NikkiRe/Robot-micromouse/README.md

# Micromouse: робот, проходящий лабиринт

> Базовый прототип сделан командой на курсе «Системы ввода-вывода» ИТМО, весна 2026 (https://github.com/krevetkot/robot).
> Навигация (симулятор, flood-fill, прошивка v2) развивается здесь — см. раздел в конце, `sim/README.md` и `firmware-v2/README.md`.

Автономный робот для соревнований Micromouse (регламент РобоФинист). Робот сам находит
путь от старта к финишу по коридорам лабиринта, без какого либо участия человека.
Прошивка написана под STM32 на голом HAL, движение строится по показаниям трёх
ИК-датчиков (реактивное управление, без построения карты).

Проект сделан в рамках дисциплины «Системы ввода-вывода».

## Что внутри

- `Core/Src/main.c` вся логика робота: управление моторами, чтение датчиков, алгоритм движения
- `Core/Inc/` заголовки и конфигурация HAL
- `Drivers/` библиотека STM32 HAL (генерируется CubeMX)
- `robot.ioc` проект STM32CubeMX (распиновка и настройка периферии)
- `STM32F401CCUX_FLASH.ld` скрипт линковки
- `Debug/` каталог сборки
- `docs/` презентация проекта

## Железо

| Компонент | Модель | Кол-во |
|---|---|---|
| Микроконтроллер | STM32 Black Pill (F401CCU6) | 1 |
| Драйвер моторов | TB6612FNG (2 канала, до 3 А) | 1 |
| Моторы | N20 micro gear, 3-6 В | 2 |
| Колёса | 30 мм | 2 |
| ИК-датчики | регулируемые, YL-63 | 3 |
| Преобразователь питания | Mini360 (DC-DC, понижающий) | 1 |
| Аккумулятор | Крона 9 В Li-Ion, 1200 мА·ч | 1 |
| Корпус | FDM-печать, PLA-пластик | 1 |

Питание: аккумулятор 9 В идёт на понижающий преобразователь Mini360, с него 3.3 В
на логику и моторы. При тестировании вся электроника заработала от 3.3 В, поэтому
оставили один преобразователь.

## Распиновка

Драйвер моторов TB6612FNG:

| Сигнал | Пин | Назначение |
|---|---|---|
| AIN1 | PA5 | правый мотор, направление 1 |
| AIN2 | PA6 | правый мотор, направление 2 |
| BIN1 | PA2 | левый мотор, направление 1 |
| BIN2 | PA3 | левый мотор, направление 2 |
| STBY | PA9 | разрешение работы драйвера (HIGH) |
| PWMA | PA8 | вход ШИМ канала A, подтянут в HIGH |

ИК-датчики (активный LOW: 0 означает препятствие):

| Датчик | Пин |
|---|---|
| правый | PB0 |
| левый | PB1 |
| центральный | PA4 |

Индикация:

| Сигнал | Пин | Назначение |
|---|---|---|
| светодиод | PC13 | загорается при обнаружении препятствия и манёвре |

## Как работает алгоритм

Робот не строит карту лабиринта. Он принимает решения по текущим показаниям
датчиков (реактивное управление). Основной цикл в `main.c`:

1. Если **спереди свободно**, едет вперёд короткими импульсами.
2. Если **спереди препятствие**, останавливается, зажигает светодиод и делает паузу,
   затем читает боковые датчики и выбирает манёвр:
   - слева свободно, справа занято -> поворот влево
   - справа свободно, слева занято -> поворот вправо
   - оба бока свободны -> поворот вправо по умолчанию
   - заблокировано со всех сторон -> сдаёт назад и разворачивается примерно на 180°
3. После поворота немного проезжает вперёд, чтобы не зациклиться у той же стены.

Скорость задаётся программным ШИМ (soft-PWM) без аппаратного таймера: робот
по очереди едет 40 мс и стоит 20 мс, что даёт примерно 67% мощности. Чтобы ехать
медленнее, уменьшите время движения или увеличьте время паузы.

Ключевые параметры (в начале `main()`):

```c
#define SPEED_ON_MS   40   // длительность импульса движения
#define SPEED_OFF_MS  20   // пауза между импульсами
#define PRE_TURN_MS   120  // пауза перед поворотом
#define POST_TURN_MS  100  // пауза после поворота
```

Длительности поворотов заданы в миллисекундах прямо в коде: примерно 450 мс на
поворот на 90° и около 840 мс на разворот. При смене колёс, мотора или заряда
батареи эти значения, скорее всего, придётся подстроить.

## Сборка и прошивка

Прошивка собирается в STM32CubeIDE.

1. Откройте папку проекта в STM32CubeIDE (`File -> Open Projects from File System`).
2. Соберите проект (`Project -> Build Project`). Готовый бинарник появится в `Debug/`.

Прошивается плата не через ST-Link, а через USB Type-C во встроенном DFU-загрузчике.
Чтобы войти в режим прошивки, нужно полностью перезагрузить STM32 в DFU:

1. Подключите плату к компьютеру кабелем USB Type-C.
2. Зажмите кнопку BOOT0, нажмите и отпустите кнопку RESET (NRST), затем отпустите
   BOOT0. После этого полного ребута плата запустится в DFU-загрузчике.
3. Прошейте бинарник через STM32CubeProgrammer (интерфейс USB) или `dfu-util`,
   например `dfu-util -a 0 -s 0x08000000:leave -D Debug/robot.bin`.
4. По завершении плата сама перезапустится в обычном режиме и начнёт работать.

Можно также открыть `robot.ioc` в STM32CubeMX, если нужно поменять распиновку или
настройки периферии, а затем перегенерировать код.

## Как запустить робота

1. Зарядите аккумулятор 9 В и вставьте его в держатель на роботе.
2. Подключите штекер питания. Робот стартует сразу, отдельной кнопки включения нет.
3. За время после включения поставьте робота в стартовую ячейку, направив датчиками
   вдоль коридора.
4. Следите за светодиодом PC13: он загорается, когда робот видит препятствие и
   начинает манёвр.

Управление полностью автономное: после включения вмешательство не требуется и не
предусмотрено. Перед заездом проверьте заряд батареи и при необходимости подстройте
пороги срабатывания ИК-датчиков под освещение в помещении (регулировочными
резисторами на самих датчиках).

## Соответствие регламенту

| Требование РобоФинист | Наш робот |
|---|---|
| Габариты менее 168 x 168 мм | в пределах лимита |
| Высота и масса | без ограничений |
| Полная автономность | STM32 + датчики, без внешнего управления |
| Не прыгать, не летать, не перелезать стены | обычный колёсный привод |

## Рекомендуемые компоненты для следующей итерации

| Компонент | Текущий | Рекомендация | Причина |
|---|---|---|---|
| Датчики расстояния | YL-63 (цифровой ИК) | **ST VL53L0X** (ToF, I²C) | Аналоговое расстояние в мм вместо бинарного сигнала, нечувствителен к внешнему освещению, рабочий диапазон 30–2000 мм покрывает все дистанции в лабиринте, питание 3.3 В |
| Моторы | N20 3–6 В (низкий RPM) | **N20 3V 265 RPM** с энкодером | 265 RPM на выходном валу даёт ~0.4 м/с при колесе 30 мм. Таким образом, увеличим скорость прохождения, оставив подходящий момент |

**Примечания по интеграции:**
- VL53L0X подключается по I²C (SDA/SCL), библиотека ST HAL доступна на GitHub. Три датчика можно повесить на одну шину, управляя пином XSHUT для назначения разных адресов.
- Повышать напряжение питания не требуется: и VL53L0X, и N20 3V работают от существующих 3.3 В.

## Известные ограничения и планы

- ИК-датчики ложно срабатывают на ярком свету. В планах подобрать другой тип
  датчиков или аналоговые датчики под ПИД-регулятор.
- Направление первого движения зависит от того, насколько ровно выставлен робот.
  Решается ПИД-регулятором для удержания курса.
- Нет кнопки включения, робот стартует сразу при подаче питания.
- Крепление моторов снизу позволит увеличить клиренс и добавить опорный подшипник.
- Моторы с большим RPM дадут больше скорости.

## Команда

- **Ксения Слонимская** схема подключения, сборка
- **Армен Арабян** закупка, 3D-моделирование, сборка
- **Кирилл Слепцов** схема подключения, программирование
- **Никита Евстигнеев** программирование, тестирование

## Состояние базового прототипа

Робот собран и запущен. Реактивное управление проверено на тестовой трассе из коробок:
робот отталкивается от стен и проходит коридор с поворотами (`docs/media/baseline-run.mp4`).
Лабиринт как задачу поиска пути базовая прошивка не решает: у неё нет карты и памяти о
пройденных клетках, поэтому на трассах с циклами она зацикливается. Это отправная точка
для навигационной части.

## Навигация: симулятор и flood-fill

Базовая прошивка не строит карту и на лабиринтах с циклами зацикливается. Чтобы подобрать алгоритм под это железо (три бинарных датчика, моторы без энкодеров), в `sim/` сделан клеточный симулятор и на 500 случайных лабиринтах 16×16 сравнены три стратегии: `reactive` (логика базовой прошивки), `right_hand` (правило правой руки) и `flood_fill` (карта стен + BFS до цели). Подробности и анимации — в `sim/README.md`.

| стратегия | решено | шагов до цели (медиана) | заезд / оптимум |
|---|---:|---:|---:|
| reactive (база) | 25.6 % | 39 | — |
| right_hand | 57.4 % | 98 | — |
| flood_fill | 100 % | 40 | 1.000 |

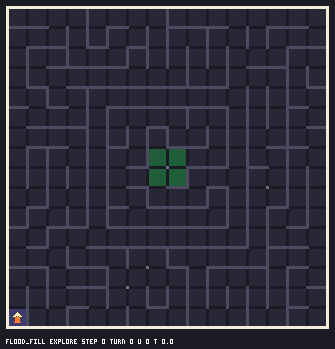
[picture p1: sim/results/viz/island16_flood_fill.gif]
flood-fill на лабиринте с островом


```bash
python -m unittest discover -s tests -t .           # 41 тест
python -m sim bench --n 500 --size 16 --seed 1      # таблица выше
python -m sim viz --maze sim/mazes/island16.txt --strategy flood_fill --out out.gif
```

Прошивка v2 (`firmware-v2/`) — тот же flood-fill на STM32F401 и той же распиновке: модули `maze / nav / motors / sensors / calib`, аппаратный ШИМ через TIM1 вместо программного, медиана по датчикам, калибровка таймингов по кнопке. Модуль карты собирается и на хосте: `cd firmware-v2/host-test && make test` (955 проверок). Ограничения те же, что у базы: движение по времени без энкодеров, бинарные датчики. Подробнее — `firmware-v2/README.md`.

Попутно нашлось расхождение в базовом проекте: в `robot.ioc` пин PA9 настроен как `TIM1_CH2`, а в коде используется как STBY драйвера; в v2 исправлено (`firmware-v2/PINOUT.md`).
