NikkiRe/Robot-micromouse/docs/Micromouse_презентация_5.pdf

// AUTONOMOUS MAZE ROBOT | · 2026

# MICROMOUSE

# Робот, проходящий лабиринт

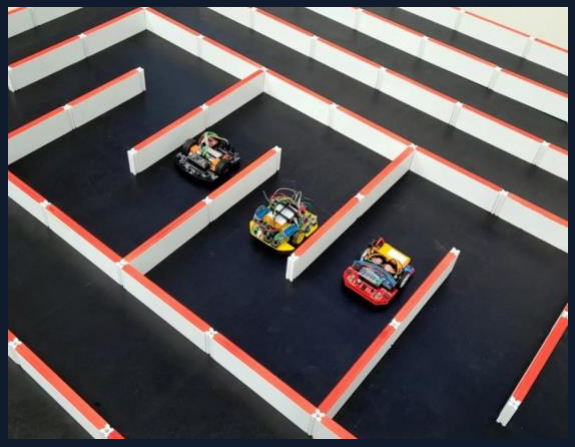
[picture p7: figure]

Проект по дисциплине | | | Цель робота — самостоятельно найти
«Системы ввода-вывода» | | | путь от старта к финишу без участия человека.
STM32F401CCU6 · | TB6612FNG · | 3× IR

СОРЕВНОВАТЕЛЬНЫЙ ЛАБИРИНТ

# Участники проекта

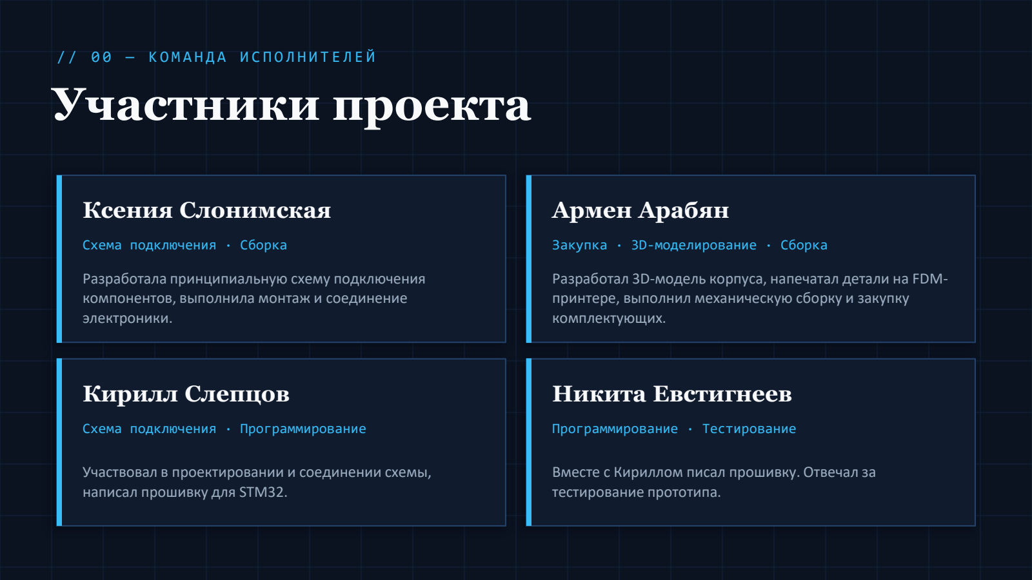
[picture p8: page 2]

/ / 0 0 — К О М А Н Д А И С П О Л Н И Т Е Л Е Й

Ксения Слонимская Схема подключения · Сборка | Армен Арабян Закупка · 3D-моделирование · | Сборка
Разработала принципиальную схему подключения компонентов, выполнила монтаж и соединение | Разработал 3D-модель корпуса, напечатал детали на FDM-принтере, выполнил механическую сборку и закупку
электроники. | комплектующих.
Кирилл Слепцов | Никита Евстигнеев
Схема подключения · Программирование | Программирование · Тестирование
Участвовал в проектировании и соединении схемы, написал прошивку для STM32. | Вместе с Кириллом писал прошивку. Отвечал за тестирование прототипа.

/ / 0 1 — О Б З О Р П Р О Е К Т А

# О проекте

| | | | STM32F401CCU6

### 01 Micromouse — соревновательная дисциплина

робототехники: автономный робот сам находит путь в лабиринте, без вмешательства человека.

### 02 Прототип на STM32 Black Pill (F401CCU6). Три ИК-датчика

читают стены по бокам и спереди, два мотора N20 с колёсами 60 мм приводят робота в движение.

03

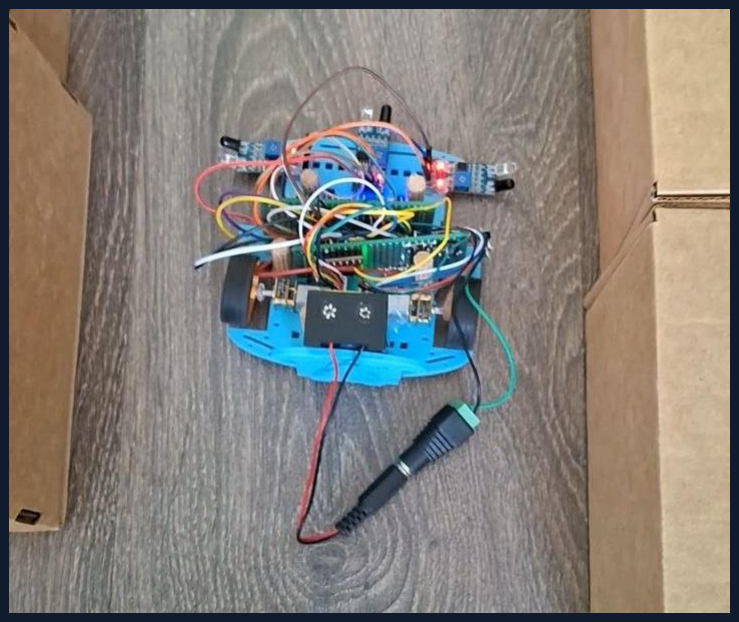
[picture p9: figure]

Питание — аккумулятор 9 В (Li-Ion, 1200 мА·ч) через понижающий преобразователь Mini360 на логику и моторы. | прототип | · реактивное | управление

/ / 0 2 — Ц Е Л Ь И З А Д А Ч И

# Цель и задачи

| Цель: победить в соревновании засчёт разработки автономного робота, способного ориентироваться в
| пространстве и двигаться по коридорам лабиринта, избегая столкновений.
1 | | Проектирование корпуса | 3D-модель компактного шасси под все компоненты
2 | | Электрическая схема | Схема подключения датчиков, моторов, драйвера и
| | контроллера
3 | Сборка прототипа | Печать корпуса, механическая и электрическая сборка
4 | Прошивка: реактивное управление | Алгоритм движения по показаниям датчиков
5 | Тестирование | Проверка на тестовых трассах, устранение ошибок

/ / 0 3 — Р Е Г Л А М Е Н Т · Р О Б О Ф И Н И С Т

# Соответствие требованиям

ТРЕБОВАНИЕ | РЕГЛАМЕНТА | | НАШ РОБОТ
Габариты (Ш×Д) | | < 250 × 250 мм | | в пределах лимита
Высота / масса | | без ограничений | | ограничений нет
Автономность | полная, без внешнего управления | STM32 + датчики
Поведение | не прыгать, не летать, не перелезать | колёсный привод

Команда из 4 человек · лабиринт от 2 до 16 ячеек · неограниченное число заездов, в зачёт идёт лучший

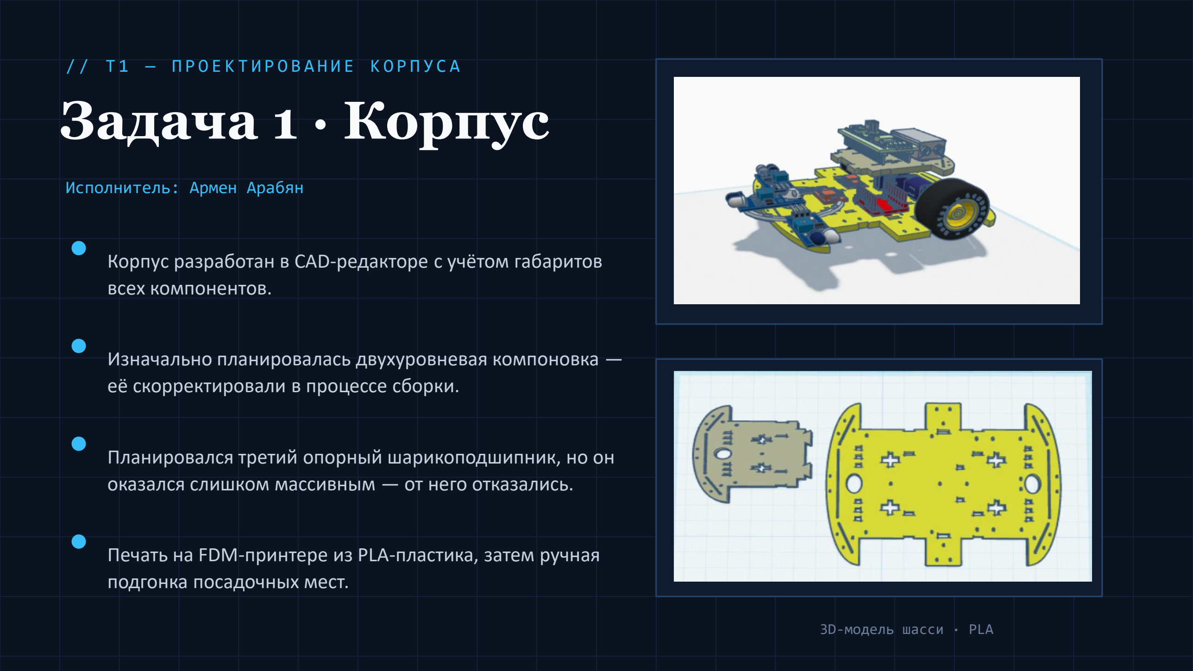
[picture p10: figure]
Задача 1 · Корпус; Исполнитель:; Армен; Арабян; Изначально планировалась двухуровневая компоновка — её скорректировали в процессе сборки.; 3D-модель; шасси · PLA

/ / T 1 — П Р О Е К Т И Р О В А Н И Е К О Р П У С А

Корпус разработан в CAD-редакторе с учётом габаритов всех компонентов.

Планировался третий опорный шарикоподшипник, но он оказался слишком массивным — от него отказались.

Печать на FDM-принтере из PLA-пластика, затем ручная подгонка посадочных мест.

/ / T 2 — С Х Е М А П О Д К Л Ю Ч Е Н И Я

# Задача 2 · Схема

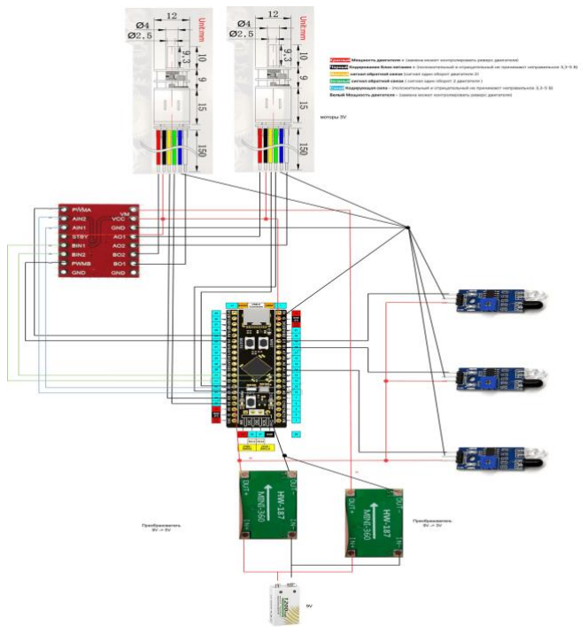
[picture p11: figure]

Исполнители: | Ксения | Слонимская · | | Кирилл Слепцов
Контроллер Драйвер моторов | | | STM32 Black Pill TB6612FNG | | — 2 канала, до 3 А | (F401CCU6)
Правый мотор | | | AIN1=PA5 · AIN2=PA6
Левый мотор | | | BIN1=PA2 · BIN2=PA3
ИК-датчики | | | право=PB0 | | · лево=PB1 · центр=PA4
Управление драйвером | | | STBY=PA9 · PWMA=PA8 (HIGH)
Питание | | | 9 В → Mini360 → 3,3 В

Решение по питанию: при тестировании вся логика заработала от 3,3 В, поэтому оставили один преобразователь.

/ / T 3 · 4 — С Б О Р К А И П Р О Ш И В К А

# Задачи 3–4 · Сборка и код

СБОРКА | ПРОШИВКА
| Реактивное управление Решения по текущим показаниям датчиков, без построения карты
| Движение вперёд
| Soft-PWM: 40 мс едем / 20 мс стоим → ~67% мощности
| Объезд препятствия
Монтаж моторов и колёс в нижней платформе Укладка проводки и пайка соединений | Стоп → читаем боковые → поворот в свободную сторону
Установка ИК-датчиков на передней части | Разворот на 180°
Крепление аккумулятора, преобразователя и штекера | Если заблокированы все стороны: назад + поворот ~840 мс

# Задача 5 · Тестирование

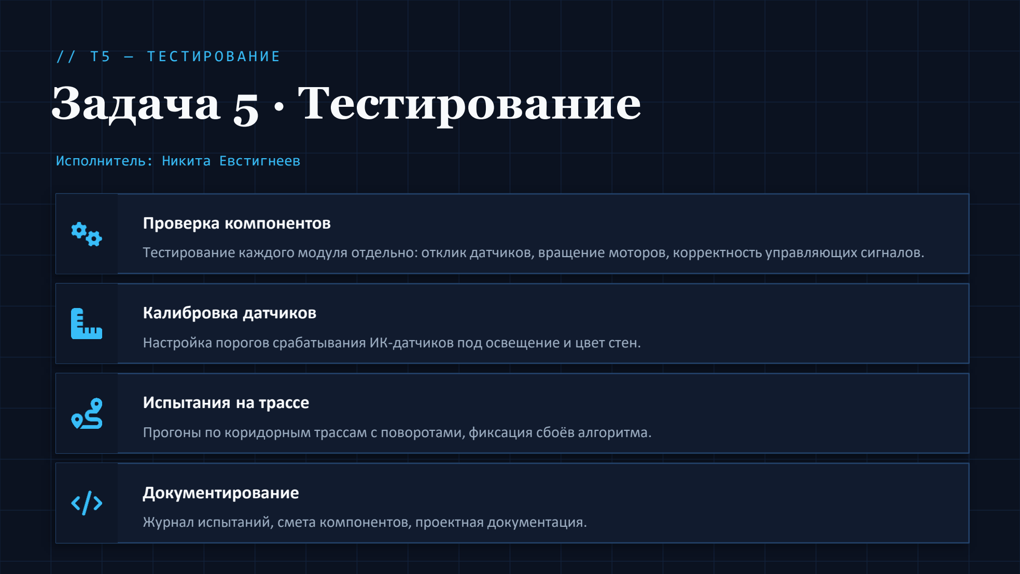
[picture p12: page 9]

/ / T 5 — Т Е С Т И Р О В А Н И Е

Исполнитель: | | Никита Евстигнеев
| Проверка компонентов Тестирование каждого модуля отдельно: отклик датчиков, вращение моторов, корректность управляющих сигналов.

Калибровка датчиков Настройка порогов срабатывания ИК-датчиков под освещение и цвет стен.

### Испытания на трассе

Прогоны по коридорным трассам с поворотами, фиксация сбоёв алгоритма.

### Документирование

Журнал испытаний, смета компонентов, проектная документация.

# Как запустить робота

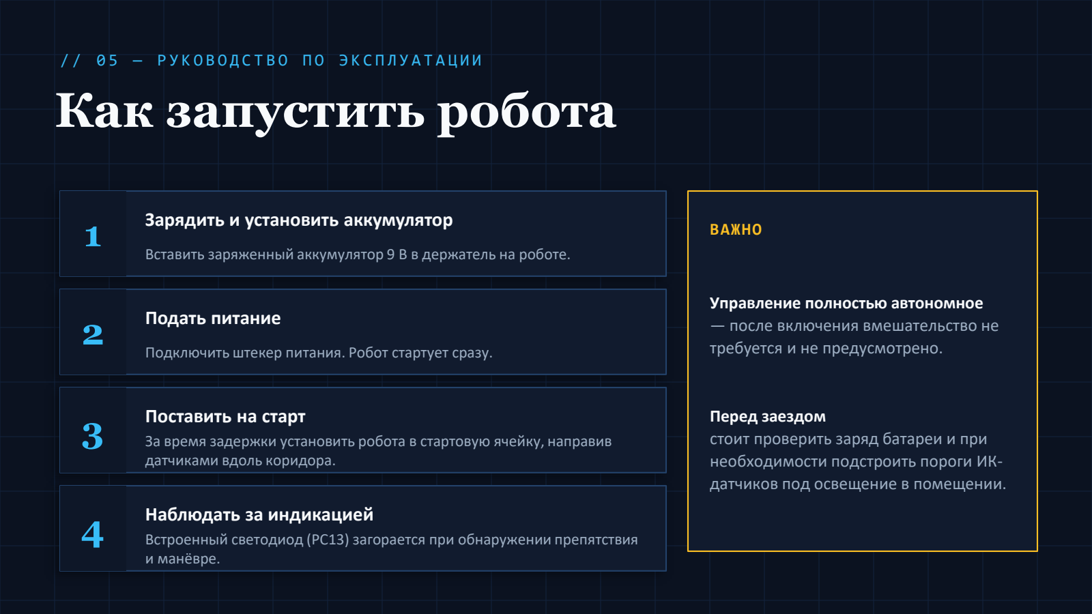
[picture p13: page 10]

/ / 0 5 — Р У К О В О Д С Т В О П О | Э К С П Л У А Т А Ц И И
1 | Вставить заряженный аккумулятор 9 В в держатель на роботе. | ВАЖНО
| Подать питание | Управление полностью автономное — после включения вмешательство не
2 | Подключить штекер питания. Робот стартует сразу. | требуется и не предусмотрено.
3 | Поставить на старт | Перед заездом стоит проверить заряд батареи и при
| За время задержки установить робота в стартовую ячейку, направив датчиками вдоль коридора. | необходимости подстроить пороги ИК-датчиков под освещение в помещении.
4 | Наблюдать за индикацией Встроенный светодиод (PC13) загорается при обнаружении препятствия
| и манёвре.

### Зарядить и установить аккумулятор

/ / 0 6 — С О С Т А В З А К У П К И · С М Е Т А

# Комплектующие

КОМПОНЕНТ | МОДЕЛЬ / ОПИСАНИЕ | КОЛ-ВО
Микроконтроллер | STM32 Black Pill (F401CCU6) | 1
Драйвер моторов | TB6612FNG | 1
Моторы | N20 micro gear, 3–6 В | 2
Колёса ИК-датчики | Omni 60 мм (левое + правое) регулируемые, YL-63 | 2 3
Преобразователь питания | Mini360 (DC-DC, понижающий) | 1
Аккумулятор | Крона 9 В Li-Ion, 1200 мА·ч | 1
Корпус | FDM-печать, PLA-пластик | 1

/ / 0 7 — И С П О Л Ь З У Е М Ы Е И С Т О Ч Н И К И

# Источники

01 Регламент соревнований Micromouse | РобоФинист — требования к роботу и лабиринту

02 Документация STM32F401 / STM32CubeIDE
| STMicroelectronics — HAL, конфигурация периферии, тактирование
03 Datasheet TB6612FNG | Toshiba — управление двигателями, распиновка драйвера
04 Спецификация моторов N20 и ИК-датчиков | Карточки комплектующих поставщиков (Ozon, AliExpress)

05 Материалы по алгоритмам прохождения лабиринта
Открытые источники по реактивному управлению и Micromouse

/ / 0 4 — Р Е З У Л Ь Т А Т Ы И П Е Р С П Е К Т И В Ы

# Результаты и перспективы

| ЧТО СДЕЛАНО | | ПЛАНЫ НА БУДУЩЕЕ
Собран и запущен полноценный прототип робота | | Датчики ложно срабатывают на ярком свету -> подобрать другой тип датчиков или датчики с другими
Реализовано реактивное управление по ИК-датчикам | | характеристиками Направление первого движения зависит от ровного выставления робота -> ПИД-регулятор для удержания
Робот проходит коридорные трассы с поворотами | | курса Для реализации ПИД-регулятора использовать
Soft-PWM обеспечивает плавность хода без аппаратного ШИМ | | аналоговые датчики Добавить кнопку включения
Собрана принципиальная схема и 3D-корпус | | Крепление моторов снизу позволит увеличить клиренс и добавить опорный шарико-подшипник
| | Использовать моторы с бОльшим RPM для увеличения скорости

Основные сложности: калибровка ИК-датчиков при разном освещении · тестирование схемы · доработка компоновки при сборке.

/ / 0 4 — Р Е З У Л Ь Т А Т Ы И П Е Р С П Е К Т И В Ы

# Github репозиторий проекта

## https://github.com/krevetkot/robot
