NikkiRe/Robot-micromouse/docs/media/chassis-cad.png

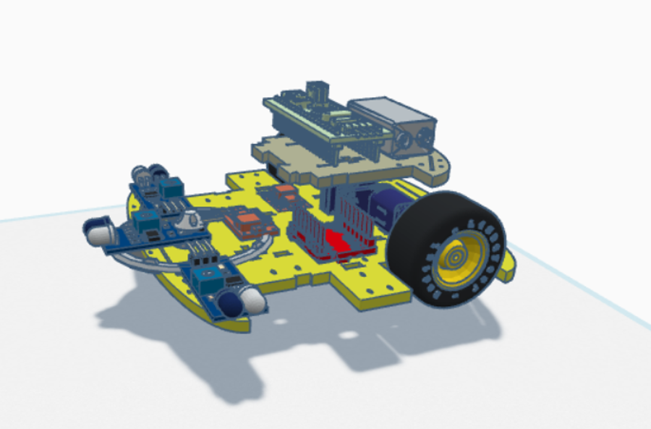
docs/media/chassis-cad.png
