NikkiRe/Robot-micromouse/docs/media/maze-competition.jpg

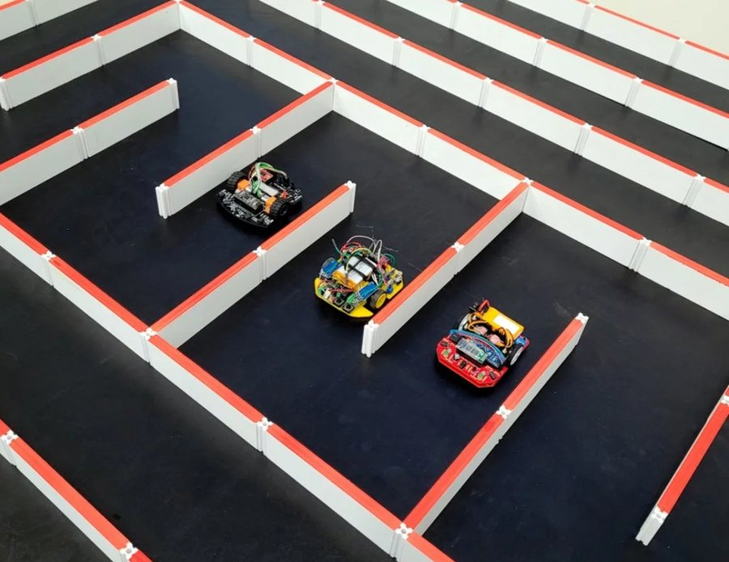
docs/media/maze-competition.jpg
