NikkiRe/Robot-micromouse/docs/media/robot.jpg

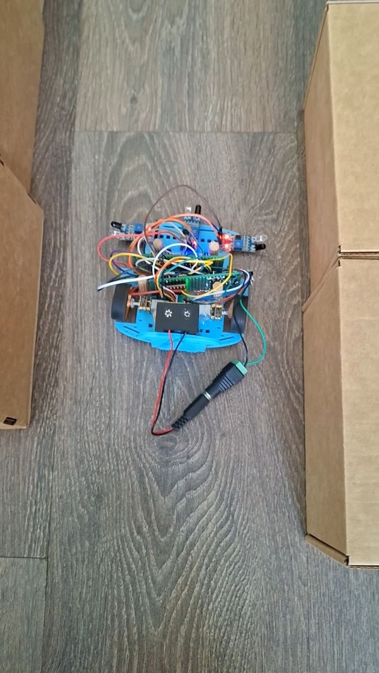
docs/media/robot.jpg
