NikkiRe/Robot-micromouse/sim/results/bench.md

# Результаты bench

Шаги, повороты, развороты и время считаются до первого попадания в цель и только по решённым прогонам. «Заезд / оптимум» — суммарная длина скоростного заезда flood fill, делённая на суммарную длину кратчайшего пути (BFS по полному лабиринту).

## 8×8, шум 0, циклов 8, лабиринтов 500, seed 1

| стратегия | решено | шаги: медиана | среднее | p90 | повороты | развороты | удары | время | заезд | оптимум | заезд / оптимум |
|---|---:|---:|---:|---:|---:|---:|---:|---:|---:|---:|---:|
| reactive | 51.8 % | 13 | 17.2 | 35 | 7.8 | 0.4 | 0.0 | 21.5 | — | 8.8 | — |
| right_hand | 69.4 % | 23 | 27.5 | 55 | 14.2 | 1.2 | 0.0 | 35.8 | — | 8.8 | — |
| flood_fill | 100.0 % | 9 | 11.4 | 21 | 6.2 | 0.1 | 0.0 | 14.7 | 8.8 | 8.8 | 1.000 |

## 8×8, шум 0.05, циклов 8, лабиринтов 500, seed 1

| стратегия | решено | шаги: медиана | среднее | p90 | повороты | развороты | удары | время | заезд | оптимум | заезд / оптимум |
|---|---:|---:|---:|---:|---:|---:|---:|---:|---:|---:|---:|
| reactive | 86.4 % | 29 | 53.3 | 135 | 23.8 | 4.3 | 1.4 | 70.2 | — | 8.8 | — |
| right_hand | 98.2 % | 37 | 50.3 | 115 | 34.7 | 3.8 | 0.7 | 71.8 | — | 8.8 | — |
| flood_fill | 100.0 % | 10 | 13.3 | 24 | 8.6 | 0.5 | 0.7 | 18.4 | 9.1 | 8.8 | 1.028 |

## 16×16, шум 0, циклов 16, лабиринтов 500, seed 1

| стратегия | решено | шаги: медиана | среднее | p90 | повороты | развороты | удары | время | заезд | оптимум | заезд / оптимум |
|---|---:|---:|---:|---:|---:|---:|---:|---:|---:|---:|---:|
| reactive | 25.6 % | 39 | 44.5 | 80 | 23.3 | 1.0 | 0.0 | 57.1 | — | 30.9 | — |
| right_hand | 57.4 % | 98 | 114.5 | 218 | 62.8 | 5.5 | 0.0 | 151.5 | — | 30.9 | — |
| flood_fill | 100.0 % | 40 | 48.3 | 89 | 27.7 | 1.0 | 0.0 | 63.2 | 30.9 | 30.9 | 1.000 |

## 16×16, шум 0.05, циклов 16, лабиринтов 500, seed 1

| стратегия | решено | шаги: медиана | среднее | p90 | повороты | развороты | удары | время | заезд | оптимум | заезд / оптимум |
|---|---:|---:|---:|---:|---:|---:|---:|---:|---:|---:|---:|
| reactive | 63.4 % | 156 | 272.2 | 704 | 131.4 | 25.8 | 7.7 | 367.6 | — | 30.9 | — |
| right_hand | 94.6 % | 222 | 303.2 | 682 | 213.4 | 23.9 | 4.7 | 436.1 | — | 30.9 | — |
| flood_fill | 100.0 % | 54 | 65.2 | 124 | 47.9 | 3.6 | 8.2 | 96.8 | 33.5 | 30.9 | 1.085 |
