NikkiRe/Robot-micromouse/sim/results/viz/island16_flood_fill.png

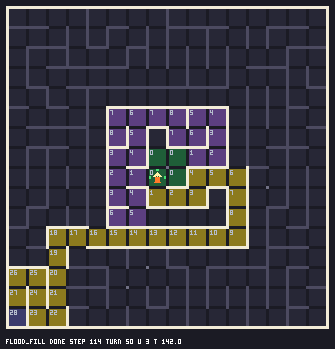
sim/results/viz/island16_flood_fill.png
