NikkiRe/Robot-micromouse/sim/results/viz/island16_reactive.png

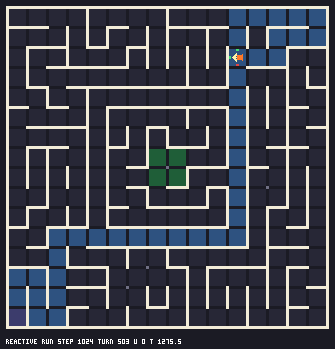
sim/results/viz/island16_reactive.png
