NikkiRe/Robot-micromouse/sim/results/viz/island16_right_hand.png

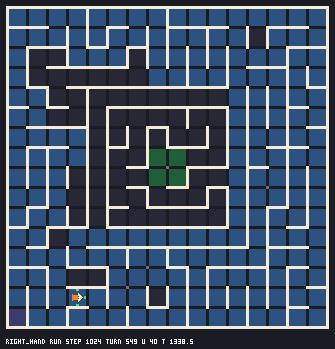
sim/results/viz/island16_right_hand.png
