NikkiRe/Robot-micromouse/sim/results/viz/loop8_flood_fill.png

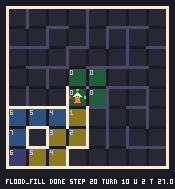
sim/results/viz/loop8_flood_fill.png
