NikkiRe/Robot-micromouse/sim/results/viz/loop8_right_hand.png

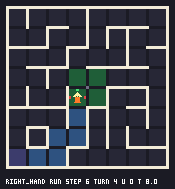
sim/results/viz/loop8_right_hand.png
