NikkiRe/Robot-micromouse/sim/results/viz/random16_flood_fill.gif

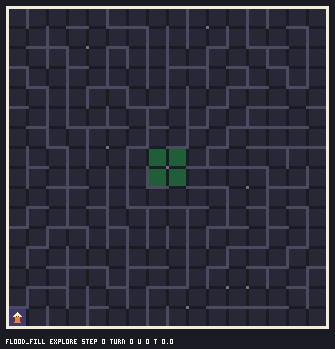
sim/results/viz/random16_flood_fill.gif
