NikkiRe/Robot-micromouse/sim/results/viz/random16_flood_fill.png

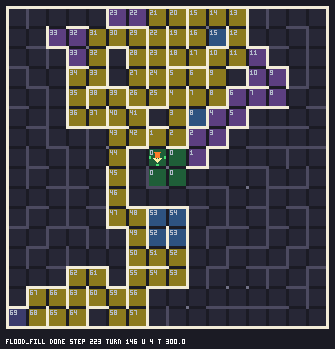
sim/results/viz/random16_flood_fill.png
