NikkiRe/Robot-micromouse/Core/Src/main.c

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
/* Includes ------------------------------------------------------------------*/
#include "main.h"

TIM_HandleTypeDef htim1;

void SystemClock_Config(void);
static void MX_GPIO_Init(void);
static void MX_TIM1_Init(void);
/* USER CODE BEGIN PFP */

// правый мотор (A): AIN1=PA5, AIN2=PA6
static void right_forward(void)  { HAL_GPIO_WritePin(GPIOA, GPIO_PIN_5, GPIO_PIN_SET);   HAL_GPIO_WritePin(GPIOA, GPIO_PIN_6, GPIO_PIN_RESET); }
static void right_backward(void) { HAL_GPIO_WritePin(GPIOA, GPIO_PIN_5, GPIO_PIN_RESET); HAL_GPIO_WritePin(GPIOA, GPIO_PIN_6, GPIO_PIN_SET);   }
static void right_stop(void)     { HAL_GPIO_WritePin(GPIOA, GPIO_PIN_5, GPIO_PIN_RESET); HAL_GPIO_WritePin(GPIOA, GPIO_PIN_6, GPIO_PIN_RESET); }

// левый мотор (B): BIN1=PA2, BIN2=PA3
static void left_forward(void)   { HAL_GPIO_WritePin(GPIOA, GPIO_PIN_2, GPIO_PIN_SET);   HAL_GPIO_WritePin(GPIOA, GPIO_PIN_3, GPIO_PIN_RESET); }
static void left_backward(void)  { HAL_GPIO_WritePin(GPIOA, GPIO_PIN_2, GPIO_PIN_RESET); HAL_GPIO_WritePin(GPIOA, GPIO_PIN_3, GPIO_PIN_SET);   }
static void left_stop(void)      { HAL_GPIO_WritePin(GPIOA, GPIO_PIN_2, GPIO_PIN_RESET); HAL_GPIO_WritePin(GPIOA, GPIO_PIN_3, GPIO_PIN_RESET); }

// комбинированные команды
static void drive_forward(void)  { right_forward();  left_forward();  }
static void drive_backward(void) { right_backward(); left_backward(); }
static void drive_stop(void)     { right_stop();     left_stop();     }
static void turn_left(void)      { right_forward();  left_backward(); }  // поворот на месте влево
static void turn_right(void)     { right_backward(); left_forward();  }  // поворот на месте вправо

// чтение датчиков (активный LOW 0 = препятствие)
static uint8_t sensor_right(void)  { return HAL_GPIO_ReadPin(GPIOB, GPIO_PIN_0) == GPIO_PIN_RESET; }
static uint8_t sensor_left(void)   { return HAL_GPIO_ReadPin(GPIOB, GPIO_PIN_1) == GPIO_PIN_RESET; }
static uint8_t sensor_center(void) { return HAL_GPIO_ReadPin(GPIOA, GPIO_PIN_4) == GPIO_PIN_RESET; }

/* USER CODE END PFP */

int main(void)
{
  GPIO_InitTypeDef GPIO_InitStruct = {0};

  HAL_Init();
  SystemClock_Config();
  MX_GPIO_Init();

  GPIO_InitStruct.Pin = GPIO_PIN_9;
  GPIO_InitStruct.Mode = GPIO_MODE_OUTPUT_PP;
  GPIO_InitStruct.Pull = GPIO_NOPULL;
  GPIO_InitStruct.Speed = GPIO_SPEED_FREQ_LOW;
  HAL_GPIO_Init(GPIOA, &GPIO_InitStruct);
  HAL_GPIO_WritePin(GPIOA, GPIO_PIN_9, GPIO_PIN_SET);

  __HAL_RCC_GPIOC_CLK_ENABLE();
  GPIO_InitStruct.Pin = GPIO_PIN_13;
  GPIO_InitStruct.Mode = GPIO_MODE_OUTPUT_PP;
  GPIO_InitStruct.Pull = GPIO_NOPULL;
  GPIO_InitStruct.Speed = GPIO_SPEED_FREQ_LOW;
  HAL_GPIO_Init(GPIOC, &GPIO_InitStruct);

  // Soft-PWM: 40 мс едем, 20 мс стоим → 67% мощности (уменьшить ON или увеличить OFF = медленнее)
  #define SPEED_ON_MS   40
  #define SPEED_OFF_MS  20
  #define PRE_TURN_MS   120   // пауза перед поворотом
  #define POST_TURN_MS  100   // пауза после поворота

  while (1)
  {
      uint8_t r = sensor_right();
      uint8_t l = sensor_left();
      uint8_t c = sensor_center();

      if (!c)
      {
          // спереди свободно — едем вперёд
          HAL_GPIO_WritePin(GPIOC, GPIO_PIN_13, GPIO_PIN_RESET);
          drive_forward();
          HAL_Delay(SPEED_ON_MS);
          drive_stop();
          HAL_Delay(SPEED_OFF_MS);
      }
      else
      {
          // спереди препятствие — полная остановка
          drive_stop();
          HAL_GPIO_WritePin(GPIOC, GPIO_PIN_13, GPIO_PIN_SET);
          HAL_Delay(PRE_TURN_MS);

          // читаем боковые только после остановки
          uint8_t sr = sensor_right();
          uint8_t sl = sensor_left();

          if (!sl && sr)
          {
              // слева свободно, справа занято — поворот влево
              turn_left();
              HAL_Delay(450);
          }
          else if (!sr && sl)
          {
              // справа свободно, слева занято — поворот вправо
              turn_right();
              HAL_Delay(450);
          }
          else if (!sl && !sr)
          {
              // оба бока свободны — поворот вправо по умолчанию
              turn_right();
              HAL_Delay(450);
          }
          else
          {
              // со всех сторон заблокировано — назад и разворот
              drive_backward();
              HAL_Delay(400);
              drive_stop();
              HAL_Delay(PRE_TURN_MS);
              turn_right();
              HAL_Delay(840);  // около 180 градусов
          }

          drive_stop();
          HAL_Delay(POST_TURN_MS);

          // уезжаем от препятствия чтобы не зациклиться
          drive_forward();
          HAL_Delay(250);
          drive_stop();
          HAL_Delay(50);
      }
  }
}

void SystemClock_Config(void)
{
  RCC_OscInitTypeDef RCC_OscInitStruct = {0};
  RCC_ClkInitTypeDef RCC_ClkInitStruct = {0};

  __HAL_RCC_PWR_CLK_ENABLE();
  __HAL_PWR_VOLTAGESCALING_CONFIG(PWR_REGULATOR_VOLTAGE_SCALE2);

  RCC_OscInitStruct.OscillatorType = RCC_OSCILLATORTYPE_HSI;
  RCC_OscInitStruct.HSIState = RCC_HSI_ON;
  RCC_OscInitStruct.HSICalibrationValue = RCC_HSICALIBRATION_DEFAULT;
  RCC_OscInitStruct.PLL.PLLState = RCC_PLL_NONE;
  if (HAL_RCC_OscConfig(&RCC_OscInitStruct) != HAL_OK)
    Error_Handler();

  RCC_ClkInitStruct.ClockType = RCC_CLOCKTYPE_HCLK|RCC_CLOCKTYPE_SYSCLK
                              |RCC_CLOCKTYPE_PCLK1|RCC_CLOCKTYPE_PCLK2;
  RCC_ClkInitStruct.SYSCLKSource = RCC_SYSCLKSOURCE_HSI;
  RCC_ClkInitStruct.AHBCLKDivider = RCC_SYSCLK_DIV1;
  RCC_ClkInitStruct.APB1CLKDivider = RCC_HCLK_DIV1;
  RCC_ClkInitStruct.APB2CLKDivider = RCC_HCLK_DIV1;

  if (HAL_RCC_ClockConfig(&RCC_ClkInitStruct, FLASH_LATENCY_0) != HAL_OK)
    Error_Handler();
}

static void MX_TIM1_Init(void)
{
  TIM_MasterConfigTypeDef sMasterConfig = {0};
  TIM_OC_InitTypeDef sConfigOC = {0};
  TIM_BreakDeadTimeConfigTypeDef sBreakDeadTimeConfig = {0};


  htim1.Instance = TIM1;
  htim1.Init.Prescaler = 0;
  htim1.Init.CounterMode = TIM_COUNTERMODE_UP;
  htim1.Init.Period = 65535;
  htim1.Init.ClockDivision = TIM_CLOCKDIVISION_DIV1;
  htim1.Init.RepetitionCounter = 0;
  htim1.Init.AutoReloadPreload = TIM_AUTORELOAD_PRELOAD_DISABLE;
  if (HAL_TIM_PWM_Init(&htim1) != HAL_OK)
    Error_Handler();

  sMasterConfig.MasterOutputTrigger = TIM_TRGO_RESET;
  sMasterConfig.MasterSlaveMode = TIM_MASTERSLAVEMODE_DISABLE;
  if (HAL_TIMEx_MasterConfigSynchronization(&htim1, &sMasterConfig) != HAL_OK)
    Error_Handler();
      sConfigOC.OCMode = TIM_OCMODE_PWM1;
  sConfigOC.Pulse = 0;
  sConfigOC.OCPolarity = TIM_OCPOLARITY_HIGH;
  sConfigOC.OCNPolarity = TIM_OCNPOLARITY_HIGH;
  sConfigOC.OCFastMode = TIM_OCFAST_DISABLE;
  sConfigOC.OCIdleState = TIM_OCIDLESTATE_RESET;
  sConfigOC.OCNIdleState = TIM_OCNIDLESTATE_RESET;
  if (HAL_TIM_PWM_ConfigChannel(&htim1, &sConfigOC, TIM_CHANNEL_2) != HAL_OK)
    Error_Handler();

  sBreakDeadTimeConfig.OffStateRunMode = TIM_OSSR_DISABLE;
  sBreakDeadTimeConfig.OffStateIDLEMode = TIM_OSSI_DISABLE;
  sBreakDeadTimeConfig.LockLevel = TIM_LOCKLEVEL_OFF;
  sBreakDeadTimeConfig.DeadTime = 0;
  sBreakDeadTimeConfig.BreakState = TIM_BREAK_DISABLE;
  sBreakDeadTimeConfig.BreakPolarity = TIM_BREAKPOLARITY_HIGH;
  sBreakDeadTimeConfig.AutomaticOutput = TIM_AUTOMATICOUTPUT_DISABLE;
  if (HAL_TIMEx_ConfigBreakDeadTime(&htim1, &sBreakDeadTimeConfig) != HAL_OK)
    Error_Handler();

  HAL_TIM_MspPostInit(&htim1);
}

static void MX_GPIO_Init(void)
{
  GPIO_InitTypeDef GPIO_InitStruct = {0};

  __HAL_RCC_GPIOA_CLK_ENABLE();
  __HAL_RCC_GPIOB_CLK_ENABLE();

  HAL_GPIO_WritePin(GPIOA, GPIO_PIN_2|GPIO_PIN_3|GPIO_PIN_5|GPIO_PIN_6, GPIO_PIN_RESET);
  HAL_GPIO_WritePin(GPIOA, GPIO_PIN_8, GPIO_PIN_SET);  // PWMA всегда HIGH

  GPIO_InitStruct.Pin = GPIO_PIN_2|GPIO_PIN_3|GPIO_PIN_5|GPIO_PIN_6|GPIO_PIN_8;
  GPIO_InitStruct.Mode = GPIO_MODE_OUTPUT_PP;
  GPIO_InitStruct.Pull = GPIO_NOPULL;
  GPIO_InitStruct.Speed = GPIO_SPEED_FREQ_LOW;
  HAL_GPIO_Init(GPIOA, &GPIO_InitStruct);

  GPIO_InitStruct.Pin = GPIO_PIN_4;
  GPIO_InitStruct.Mode = GPIO_MODE_INPUT;
  GPIO_InitStruct.Pull = GPIO_PULLUP;
  HAL_GPIO_Init(GPIOA, &GPIO_InitStruct);

  GPIO_InitStruct.Pin = GPIO_PIN_0|GPIO_PIN_1|GPIO_PIN_8|GPIO_PIN_9;
  GPIO_InitStruct.Mode = GPIO_MODE_INPUT;
  GPIO_InitStruct.Pull = GPIO_PULLUP;
  HAL_GPIO_Init(GPIOB, &GPIO_InitStruct);
}

void Error_Handler(void)
{
  __disable_irq();
  while (1) {}
}

#ifdef USE_FULL_ASSERT
void assert_failed(uint8_t *file, uint32_t line) {}
#endif
