NikkiRe/Robot-micromouse/(commit log)

2026-06-10 Базовый прототип Micromouse: командная версия (реактивное управление, STM32F401)
2026-09-14 sim: модель лабиринта Micromouse и робота с тремя бинарными датчиками
2026-09-18 sim: стратегии навигации (реактивная, правая рука, flood-fill), бенчмарк и CLI
2026-09-22 sim: пиксельная визуализация прогонов (PNG/GIF без внешних библиотек)
2026-09-24 sim: результаты бенчмарка (n=500) и анимации для трёх лабиринтов
    [bench.csv]
2026-09-25 firmware-v2: модуль карты и flood-fill на статической памяти, хостовые тесты
2026-09-26 firmware-v2: аппаратный ШИМ, датчики с медианой, машина состояний навигации, калибровка
2026-09-27 firmware-v2: убрать неизмеренный размер прошивки из README
2026-09-27 README: раздел о навигации, результаты симулятора и прошивка v2
